mak22223/MPS_Course_Work/Технические документы/ГОСТы/19.105 ЕСПД Общие требования к программным документам.pdf

обязательная (http://www.stroyinf.ru/fire.html) | пожарная (http://www.stroyinf.ru/fire.html) | сертификация (http://www.stroyinf.ru/fire.html)
