mak22223/MPS_Course_Work/Документация/Прочее/Program Functional.png

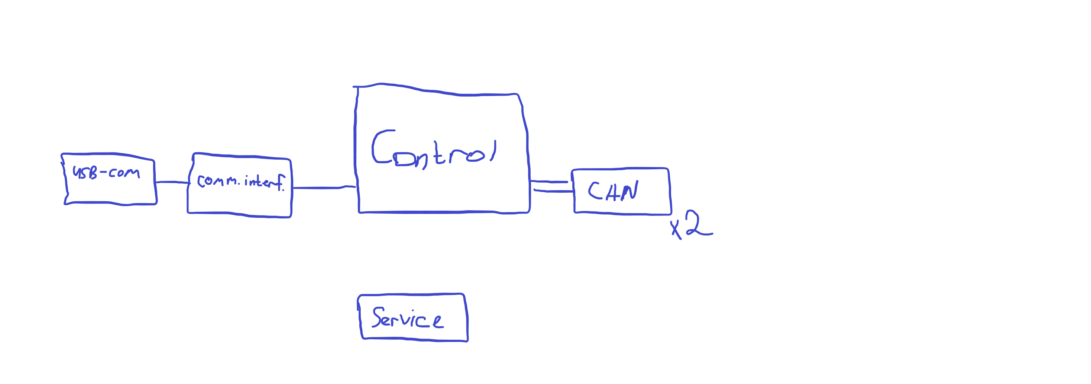
Документация/Прочее/Program Functional.png
