mak22223/MPS_Course_Work/Технические документы/Примеры схем/CAN модуль.png

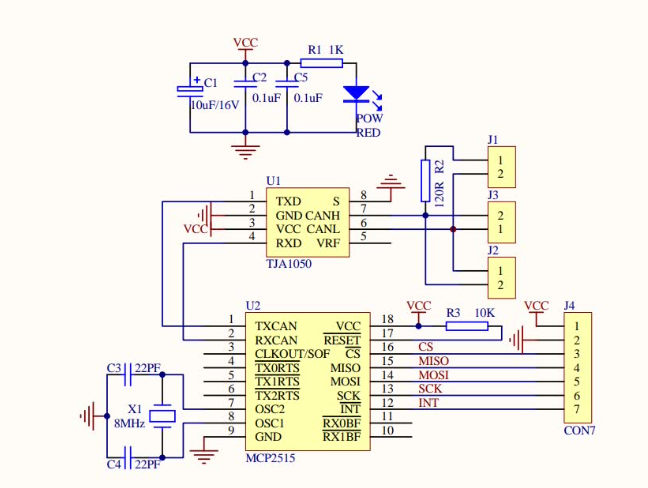
Технические документы/Примеры схем/CAN модуль.png
