mak22223/MPS_Course_Work/Сбор компонентов.xlsx

Description | Comment | Part Number | Quantity | Стоимость | Аналог? | Ссылка
25V 100nF X7R ±10% 0603 Multilayer Ceramic Capacitors MLCC | 100 nF | CL10B104KA8NNNC | 9 | 56,98
25V 10uF X5R ±20% 0603 Multilayer Ceramic Capacitors | 10 uF | CL10A106MA8NRNC | 2 | 200 |  | https://www.chipdip.ru/product0/8016016324
25V 22uF X5R ±20% 0805 Multilayer Ceramic Capacitors | 22 uF | CL21A226MAYNNNE | 2 | 175.00 ₽ |  | https://www.chipdip.ru/product0/8008936943
25V 1uF X5R ±10% 0603 Multilayer Ceramic Capacitors MLCC | 1 uF | CC0603KRX5R8BB105 | 4 | 68,03
 | 12pf | CC0603JRNPO9BN120 | 2 | 56.98 ₽
50V 10pF NP0 ±5% 0603 Multilayer Ceramic Capacitors MLCC | 10 pF | CC0603JRNPO9BN100 | 2 | 56.98 ₽
20V 450mV@1A 1A SOD-323 Schottky Barrier Diodes | Diode Shottky SOD-323 | B5817WS | 1 | 18.00 ₽ | BAT60JFILM | https://www.chipdip.ru/product/bat60jfilm
5mA Yellow -40℃~+85℃ White light 120° 100mW 0603 Light Emitting Diodes (LED) ROHS | LED White | SZYY0603W | 1 | 75.73 ₽ |  | https://aliexpress.ru/item/4000160742329.html
20mA 518nm Colorless transparence -40℃~+85℃ 520nm~535nm Emerald 120° 110mW 0603 | LED Green 0603 | 19-217/GHC-YR1S2/3T | 1
25mA Green -30℃~+85℃ Positive post Blue 120° 80mW 0603 | LED Blue 0603 | XL-1608BGWC-06 | 1
5A 1 16 Female Type-C SMD USB Connectors ROHS | TYPE-C-31-M-12 | TYPE-C-31-M-12 | 1 | 98.08 ₽
2.2A 3.3uH ±20% 2.8A 102mΩ SMD-2P,4x4mm Inductors | 3.3 mH | FDSD0412-H-3R3M=P3 | 1 | 30.00 ₽ |  | https://www.chipdip.ru/product0/8001584325
Resistor 5.1k 0603 1% | 5.1k | RC0603FR-075K1L | 2 | 33.00 ₽ |  | https://aliexpress.ru/item/1005001658504802.html
Resistor 10k 0603 1% | 10k | RC0603FR-0710KL | 5 | 33.59 ₽ |  | https://aliexpress.ru/item/1005001793547200.html
100mW Thick Film Resistors 75V ±100ppm/℃ ±1% -55℃~+155℃ 54.9kΩ 0603 | 54.9k | RC0603FR-0754K9L | 1 | 73.83 ₽ |  | https://aliexpress.ru/item/1005001658788791.html
100mW Thick Film Resistors 75V ±100ppm/℃ ±1% -55℃~+155℃ 698Ω 0603 Chip Resistor | 698 | AC0603FR-07698RL | 3 | 90.13 ₽ |  | https://aliexpress.ru/item/1005002761398457.html
Resistor 2.49k 0603 1% | 2.49k | RC0603FR-072K49L | 1 | 33.59 ₽ | 2,4k
100mW Thin Film Resistor 75V ±25ppm/℃ ±1% -55℃~+155℃ 33kΩ 0603 Chip Resistor | 33k | ARG03FTC3302 | 1 | 33.59 ₽
100mW Thick Film Resistors 50V ±100ppm/℃ ±1% -55℃~+155℃ 82kΩ 0603 Chip Resistor | 82k | FRC0603F8202TS | 1 | 33.59 ₽
Thick Film Resistors -55℃~+155℃ 0Ω 0603 Chip Resistor | 0 | FRC0603P000 TS | 2 | 33.59 ₽
 | SPST Switch | B3U-1000P | 1 | 28.84 ₽ | 3X4X2.5MM | https://aliexpress.ru/item/1005004067514307.html
TJA1050 CAN Transeiver up to 1 Mbaud/s | TJA1050 | TJA1057T/1Z | 2 | 284.15 ₽ | TJA1042 | https://aliexpress.ru/item/32859530246.html
 | USBLC6-2 | USBLC6-2SC6 | 1 | 69.96 ₽ |  | https://aliexpress.ru/item/32523780535.html
Step-down type -40℃~+125℃@(TJ) 1 Step-down Adjustable 0.768V~7V 3A 4.5V~17V 580kHz SOT-23-THIN-6 | TPS563201 | TPS563201DDCR | 1 | 94.47 ₽ |  | https://aliexpress.ru/item/32960176118.html
40dB@(1kHz) 100mA 240mV@(50mA) Fixed 3.3V~3.3V Positive 1 8V SOT-23 Linear Voltage Regulators | XC6206P332MR | XC6206P332MR | 1 | 69.23 ₽ |  | https://aliexpress.ru/item/32843668794.html
ARM Cortex-M3 32-bit MCU, 128 KB Flash, 64 KB Internal RAM, 51 I/Os, 64-pin LQFP, -40 to 85 degC, Tray | STM32F105RBT6 | STM32F105RBT6 | 1 | 342.58 ₽ | ??? | https://aliexpress.ru/item/1005003822567413.html
32.768kHz 6pF 70kΩ ±20ppm -40℃~+85℃ SMD3215-2P Crystals ROHS | 32.768MHz | NX3215SA-32.768K-STD-MUA-14 | 1 | 88.00 ₽ |  | https://www.chipdip.ru/product0/9000523964
Crystal 8MHz 10pf 250Ohm | 8MHz | TAXM8M4RDBCCT2T | 1 | 45.00 ₽ | ??? | https://www.chipdip.ru/product0/8010530408 | Можно? | https://www.chipdip.ru/product0/9000523954 | https://www.chipdip.ru/product0/8010531849
 |  |  |  | 2097.91
