mak22223/MPS_Course_Work/ТЗ.xlsx

Sheet: Функциональные требования
Техническое задание для адаптера J2534
Поддерживаемые функции: |  | Общие характеристики: |  |  | Задачи устройства:
1 |  | 1 | Работа в бортовых сетях +12В |  | 1 | Подключение к ТС посредством разъема J1962
2 |  | 2 | Поддержка CAN (J1962) |  | 2 | Наличие внешних выводов для подключения шин CAN
 |  | 3 | Поддержка MS-CAN
 |  | 4 | Наличие внешних выводов для подключения шин CAN |  | 3 | Связь с ЭВМ посредством USB
 |  |  |  |  | 4 | Питание устройства как от БС автомобиля, так и от USB +5V
 |  | 5 | Питание от USB
 |  | 6 | Передача данных по USB |  | 5 | Соответствие информационного интерфейса стандарту J2534
 |  |  |  |  | 6 | В рамках одного сеанса J2534 одновременно: а) Читать из двух различных шин CAN б) Записывать в две различные шины CAN
Список сокращений |  |  | Микросхемы
БС | бортовая сеть |  | LM317M
ТС | транспортное средство |  | L9637
 |  |  | XL1509 | DC-DC Step Down

Sheet: Использованные источники
Использованные документы
Номер | Название | Ссылка | Дата обращения
1 | Linear and Switching Voltage Regulator Fundamentals | https://www.ti.com/lit/an/snva558/snva558.pdf | 2022-09-25
2 | LDO Basics | https://www.ti.com/lit/eb/slyy151a/slyy151a.pdf | 2022-09-25
3 | USB Orientation & Mount Types | https://gct.co/usb-connector/usb-orientations-and-mount-types | 2022-10-15
4 | USB Type-C | https://ru.wikipedia.org/wiki/USB_Type-C | 2022-10-15
5 | USBLC6-2 Datasheet | https://www.st.com/resource/en/datasheet/usblc6-2.pdf | 2022-10-16 | https://static.chipdip.ru/lib/472/DOC014472505.pdf
6 | USB Type C: распиновка, режимы и особенности применения | http://digitrode.ru/articles/1697-usb-type-c-raspinovka-rezhimy-i-osobennosti-primeneniya.html | 2022-10-17
7 | Как начать использовать USB Type-C в своих разработках | https://habr.com/ru/company/ntc-vulkan/blog/496882/ | 2022-10-17
8 | Oscillator design guide | https://www.st.com/resource/en/application_note/an2867-oscillator-design-guide-for-stm8afals-stm32-mcus-and-mpus-stmicroelectronics.pdf | 2022-10-23
9 | Интерфейс JTAG? — Это очень просто | https://habr.com/ru/post/190012/ | 2022-10-24
10 | STM32 microcontroller debug toolbox | https://www.st.com/resource/en/application_note/an4989-stm32-microcontroller-debug-toolbox-stmicroelectronics.pdf | 2022-10-24
11 | Switching regulator fundamentals | https://www.ti.com/lit/an/snva559c/snva559c.pdf?ts=1668033055473 | 2022-11-10
12 | TPS56320x Datasheet | https://www.ti.com/lit/ds/symlink/tps563201.pdf?ts=1668072977388 | 2022-11-10
13 | PCB Layout Guidelines for Power Controllers | https://www.ti.com/lit/ml/slua366/slua366.pdf | 2022-11-10
14 | Altium Academy Youtube Channel | https://www.youtube.com/@AltiumAcademy | 2022-11-14
15 | EEVblog Youtube Channel | https://www.youtube.com/@EEVblog | 2022-11-13
16 | Altium Education | https://education.altium.com/ | 2022-09-24
17 | Introduction to USB with STM32 | https://wiki.stmicroelectronics.cn/stm32mcu/wiki/Introduction_to_USB_with_STM32 | 2022-12-19
18
19
20
21
22
23
24
25
26
27
28
29
30
31
32
33
34

Sheet: VCP Protocol
1 | Команда | PassThruConnect | Все числа в шестнадцатиричной системе
 | Входной синтаксис | connect 5,c001 (ProtocolID, Flags)
 | Выходной синтаксис | 1 (ChannelID) / NOT_SUPPORTED (Error Code)
2 | Команда | PassThruDisconnect
 | Входной синтаксис | disconnect 1 (ChannelID)
 | Выходной синтаксис | OK (Error Code)
3 | Команда | PassThruReadMsgs
 | Входной синтаксис | readmsgs 1,2,10 (ChannelID, NumMsgs, Timeout)
 | Выходной синтаксис | Сообщения протокола, разделенные '\r' / ERROR (Error Code)
4 | Команда | PassThruWriteMsgs
 | Входной синтаксис | writemsgs 1,01A4C3D29D93F2A000C (ChannelID, Msg)
 | Выходной синтаксис | OK (Error Code)
 | Ограничения | Нет возможности отправить несколько сообщений за раз
5 | Команда | PassThruStartPeriodicMsg
 | Входной синтаксис | startperiodicmsgs 1,01A4C3D29D93F2A000C,100 (ChannelID, Msg, TimeInterval)
 | Выходной синтаксис | 3 (MsgID) / ERROR (Error Code)
6 | Команда | PassThruStopPeriodicMsg
 | Входной синтаксис | stopperiodicmsgs 1,3 (ChannelID, MsgID)
 | Выходной синтаксис | OK (Error Code)
7 | Команда | PassThruStartMsgFilter
 | Входной синтаксис | startmsgfilter 1,0,21df432ab432,2123afc321,21ad3424 (ChannelID, FilterType, MaskMsg, PatternMsg, FlowControlMsg)
 | Выходной синтаксис | 5 (MsgID) / ERROR (Error Code)
8 | Команда | PassThruStopMsgFilter
 | Входной синтаксис | stopmsgfilter 1,5 (ChannelID, MsgID)
 | Выходной синтаксис | OK (Error Code)
9 | Команда | PassThruSetProgrammingVoltage
 | Входной синтаксис | setprogvoltage 6,20000 (PinNumber, Voltage)
 | Выходной синтаксис | OK (Error Code)
10 | Команда | PassThruReadVersion
 | Входной синтаксис | readversion
 | Выходной синтаксис | Firmware version string / ERROR (Error Code)
11 | Команда | PassThruGetLastError
 | Входной синтаксис | getlasterror
 | Выходной синтаксис | Error String / ERROR (Error Code)
12 | Команда | PassThruIoctl
 | Входной синтаксис | ioctl 1,7,9032ad214f (ChannelID, IoctlID, Input)
 | Выходной синтаксис | Output structure / ERROR (Error Code)
12.1 | Команда | PassThruIoctl (GET_CONFIG)
 | Входной синтаксис | ioctl 1,1,5,2,3,5,6,9 (количество и список запрашиваемых параметров)
 | Выходной синтаксис | Список параметров, разделенные '\r' / ERROR (Error Code)
12.2 | Команда | PassThruIoctl (SET_CONFIG)
 | Входной синтаксис | ioctl 1,2,5,2,500,3,200,5,600,6,1,9,0 (количество пар, параметров и значений)
 | Выходной синтаксис | OK (Error Code) (или список кодов ошибок)

Sheet: Функциональные блоки
Debug connector |  | SAE J1962 connector |  | Main module
1 | Подключение отладочных интерфейсов JTAG/SWD к МК | 1 | Подключение питания +12В и земли | 1 | Управление PPS
 |  | 2 | Подключение HS CAN и MS CAN | 2 | Отправка и чтение из шины CAN
2 | Подача питания на МК | 3 | Подключение программируемого источника питания | 3 | Выбор шины CAN
 |  |  |  | 4 | Измерение напряжения бортовой сети
 |  |  |  | 5 | Работа с USB
Power supply |  | USB connector |  | 6 | Работа с JTAG/SWD
1 | Одновременное питание от +12В и +5В | 1 | Подключение питания +5В
2 | Питание МК и периферии | 2 | Подключение линий данных USB к МК
3 | Замер напряжения бортовой сети
CAN transceiver |  | Programmable power supply
1 | Переключение между HS/MS CAN | 1 | Выбор выходного напряжения 5-20В
 |  | 2 | Осуществление подачи напряжения на выходы 6, 9, 11, 12, 13, 14
 |  | 3 | Замыкание на землю контакта 15

Sheet: Компоненты
Список компонентов
Номер | Part Number | Название | Кол-во | Ссылка
1 | 105450-0101 | Type-C Receptable Top-Mount | 1 | (тык) (https://www.molex.com/molex/products/part-detail/io_connectors/1054500101) | PLS | https://static.chipdip.ru/lib/977/DOC005977245.pdf
2 | GD32F105RBT6 | Microcontroller | 1 | (тык) (https://www.gigadevice.com/microcontroller/gd32f105rbt6/)
3 | TAXM8M4RDBCCT2T | Crystal Oscillator |  | (тык)
4 |  |  |  | (тык)
5 |  |  |  | (тык)
6 |  |  |  | (тык)
7 |  |  |  | (тык)
8 |  |  |  | (тык)
9 |  |  |  | (тык)
10 |  |  |  | (тык)
11 |  |  |  | (тык)
12 |  |  |  | (тык)
13 |  |  |  | (тык)
14 |  |  |  | (тык)
15 |  |  |  | (тык)
16 |  |  |  | (тык)
17 |  |  |  | (тык)
18 |  |  |  | (тык)
19 |  |  |  | (тык)
20 |  |  |  | (тык)
21 |  |  |  | (тык)
22 |  |  |  | (тык)
23 |  |  |  | (тык)

Sheet: Кварц
Расчет цепей кварцевого резонатора:
Параметры резонатора |  |  |  |  | Константы | Переменные:
C_L, pF | C_0, pF | ESR, Ohm | F, MHz | Dlmax, uW | g_m, A/V | R_EXT
10 | 7 | 250 | 8 | 10 | 0.025 | 10000
g_mcrit | 0.000730192812 | A/V | Iqmax | 0.0002
g_mcritREXT |  | A/V | Iq | 0.0132
gain_margin | #DIV/0! |  | IQREXT | 0.0003219512195 | нет

Sheet: DC-DC
DC-DC
IIp-p | 1.795977011 | 5.00 | x | 16.00 | - | 5.00
 |  | 16.00 |  | 3.3e-06 | x | 580000
Iipeak | 1.397988506 | 0.5 | + | 1.795977011
 |  |  |  | 2
ILO(RMS) | 0.720273873 | 0.25 | + | 1 | 3.225533426
 |  |  |  | 12

Sheet: CAN Timing
 | Скорость тактирования | 8 | МГц | Tq | 1.6e-08
 |  |  |  | Подбираемые |  |  |  | Результирующие |  | Вычисления
 | Константы | Скорость, кГц | Sample Point | BRP | PRSEG | PHSEG1 | PHSEG2 | Скорость, кГц | Sample Point | Tq | Desirable Bit Time | Bit Time | Tdelay | SyncSeg | Func | PS+PS1 | PS2 | BRP MAX | PRSEG MAX | PHSEG1 MAX | PHSEG2 MAX | PHSEG2 MIN
SJW | 0 | 250 | 0.685 | 0 | 4 | 4 | 4 | 250 | 0.6875 | 2.5e-07 | 4e-06 | 4e-06 | 2 | 1 | 6.25e-06 | 10 | 5 | 63 | 7 | 7 | 7 | 2 | #NAME? | 4 | #VALUE! | TRUE | TRUE | TRUE | TRUE | TRUE | TRUE | TRUE | TRUE | 32767 | 0
SAM | 0 | 250 | 0.8 | 0 | 6 | 4 | 2 | 250 | 0.8125 | 2.5e-07 | 4e-06 | 4e-06 | 2 | 1 | 0.00015625 | 12 | 3 | 63 | 7 | 7 | 7 | 2 | #NAME? | 4 | #VALUE! | TRUE | TRUE | TRUE | TRUE | TRUE | TRUE | TRUE | TRUE | 32767 | 0
BTLMODE | 1 | 500 | 0.685 | 0 | 1 | 1 | 2 | 500 | 0.625 | 2.5e-07 | 2e-06 | 2e-06 | 2 | 1 | 0.0036 | 4 | 3 | 63 | 7 | 7 | 7 | 2 | #NAME? | 4 | #VALUE! | TRUE | TRUE | TRUE | TRUE | TRUE | TRUE | TRUE | TRUE | 32767 | 0
SOF | 0 | 500 | 0.8 | 0 | 0 | 2 | 2 | 500 | 0.625 | 2.5e-07 | 2e-06 | 2e-06 | 2 | 1 | 0.030625 | 4 | 3 | 63 | 7 | 7 | 7 | 2 | #NAME? | 4 | #VALUE! | TRUE | TRUE | TRUE | TRUE | TRUE | TRUE | TRUE | TRUE | 32767 | 0
WAKFIL | 0 | 125 | 0.685 | 1 | 1 | 6 | 5 | 125 | 0.625 | 5e-07 | 8e-06 | 8e-06 | 2 | 1 | 0.0036 | 9 | 6 | 63 | 7 | 7 | 7 | 2 | #NAME? | 4 | #VALUE! | TRUE | TRUE | TRUE | TRUE | TRUE | TRUE | TRUE | TRUE | 32767 | 0
 |  | 125 | 0.8 | 1 | 4 | 6 | 2 | 125 | 0.8125 | 5e-07 | 8e-06 | 8e-06 | 2 | 1 | 0.00015625 | 12 | 3 | 63 | 7 | 7 | 7 | 2 | #NAME? | 4 | #VALUE! | TRUE | TRUE | TRUE | TRUE | TRUE | TRUE | TRUE | TRUE | 32767 | 0

Sheet: Функциональные объекты
USB-COM: | Входные сигналы | Выходные сигналы
Установка скорости соединения
Взаимодействие с ПК
Communication Interface:
Обработка сигналов от COM
Вызов необходимых обработчиков от Control
Обратная связь к ПК
CAN_MCP2515:
Инициализация MCP2515
Обработка прерываний (чтение/отправка сообщений)
Настройка параметров CAN
Установка фильтров
Control:
Управление интерфейсами
Обработка команд от интерфейса взаимодействия
Service:
Первичная настройка МК и периферии

Sheet: Недочеты
 | Плата
1 | Расчет тока светодиодов проведен неверно (номиналов резисторов)
2 | Светодиоды возможно имеет смысл подключать к 5V линии.
3 | Светодиодами стоит управлять в режиме открытого коллектора
4 | Проверить выбранную катушку на ток
 | Код
1 | Возвращаемое значение метода isCapableOf должно зависеть не только от интерфейса
2 | Класс MCP2515 не разделяет расширенные и стандартные кадры и не может работать с ISO15765
