mak22223/MPS_Course_Work/Документация/PDF/МаркинМА_ИУ6-74Б_Перечень_элементов.pdf

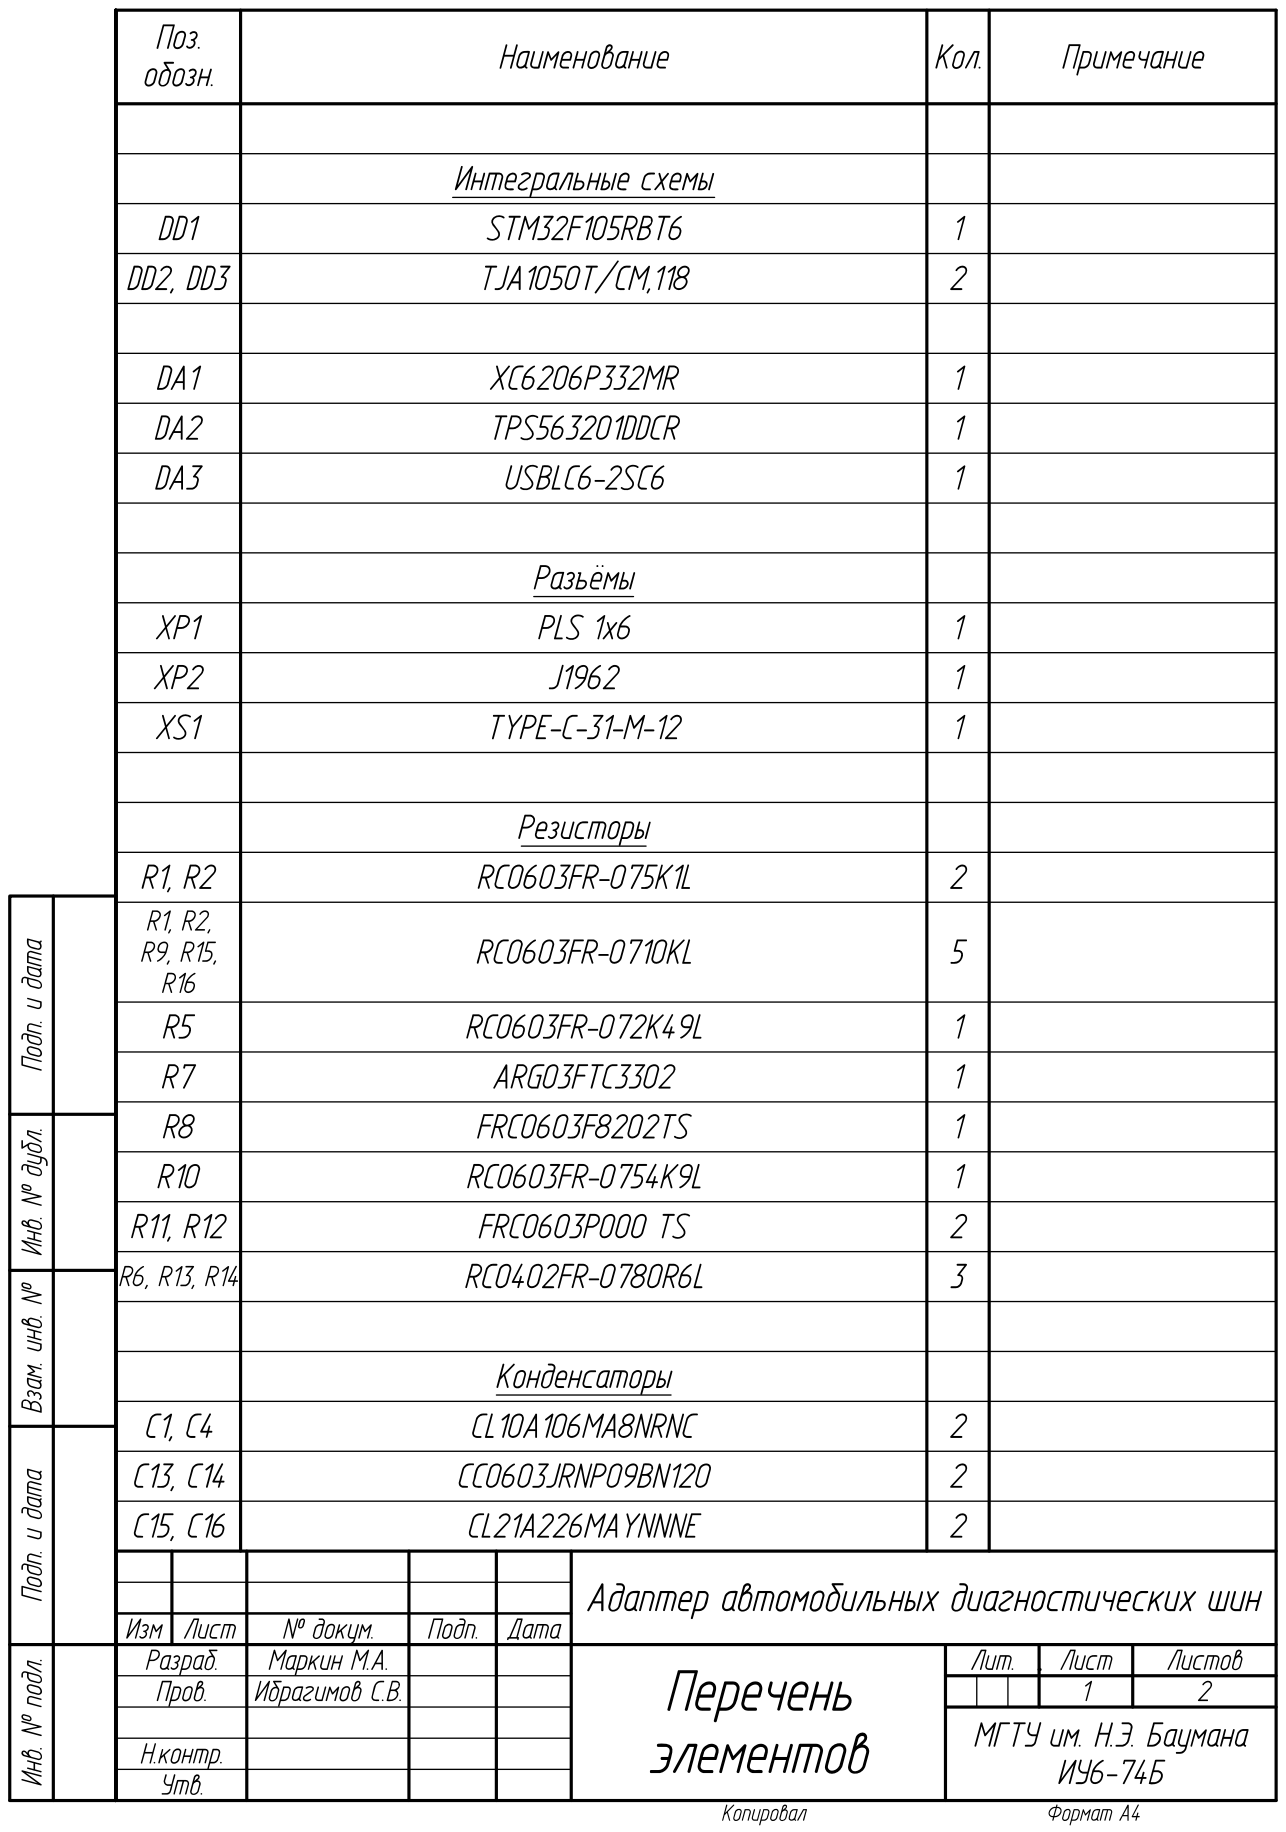
[picture p40: page 1]

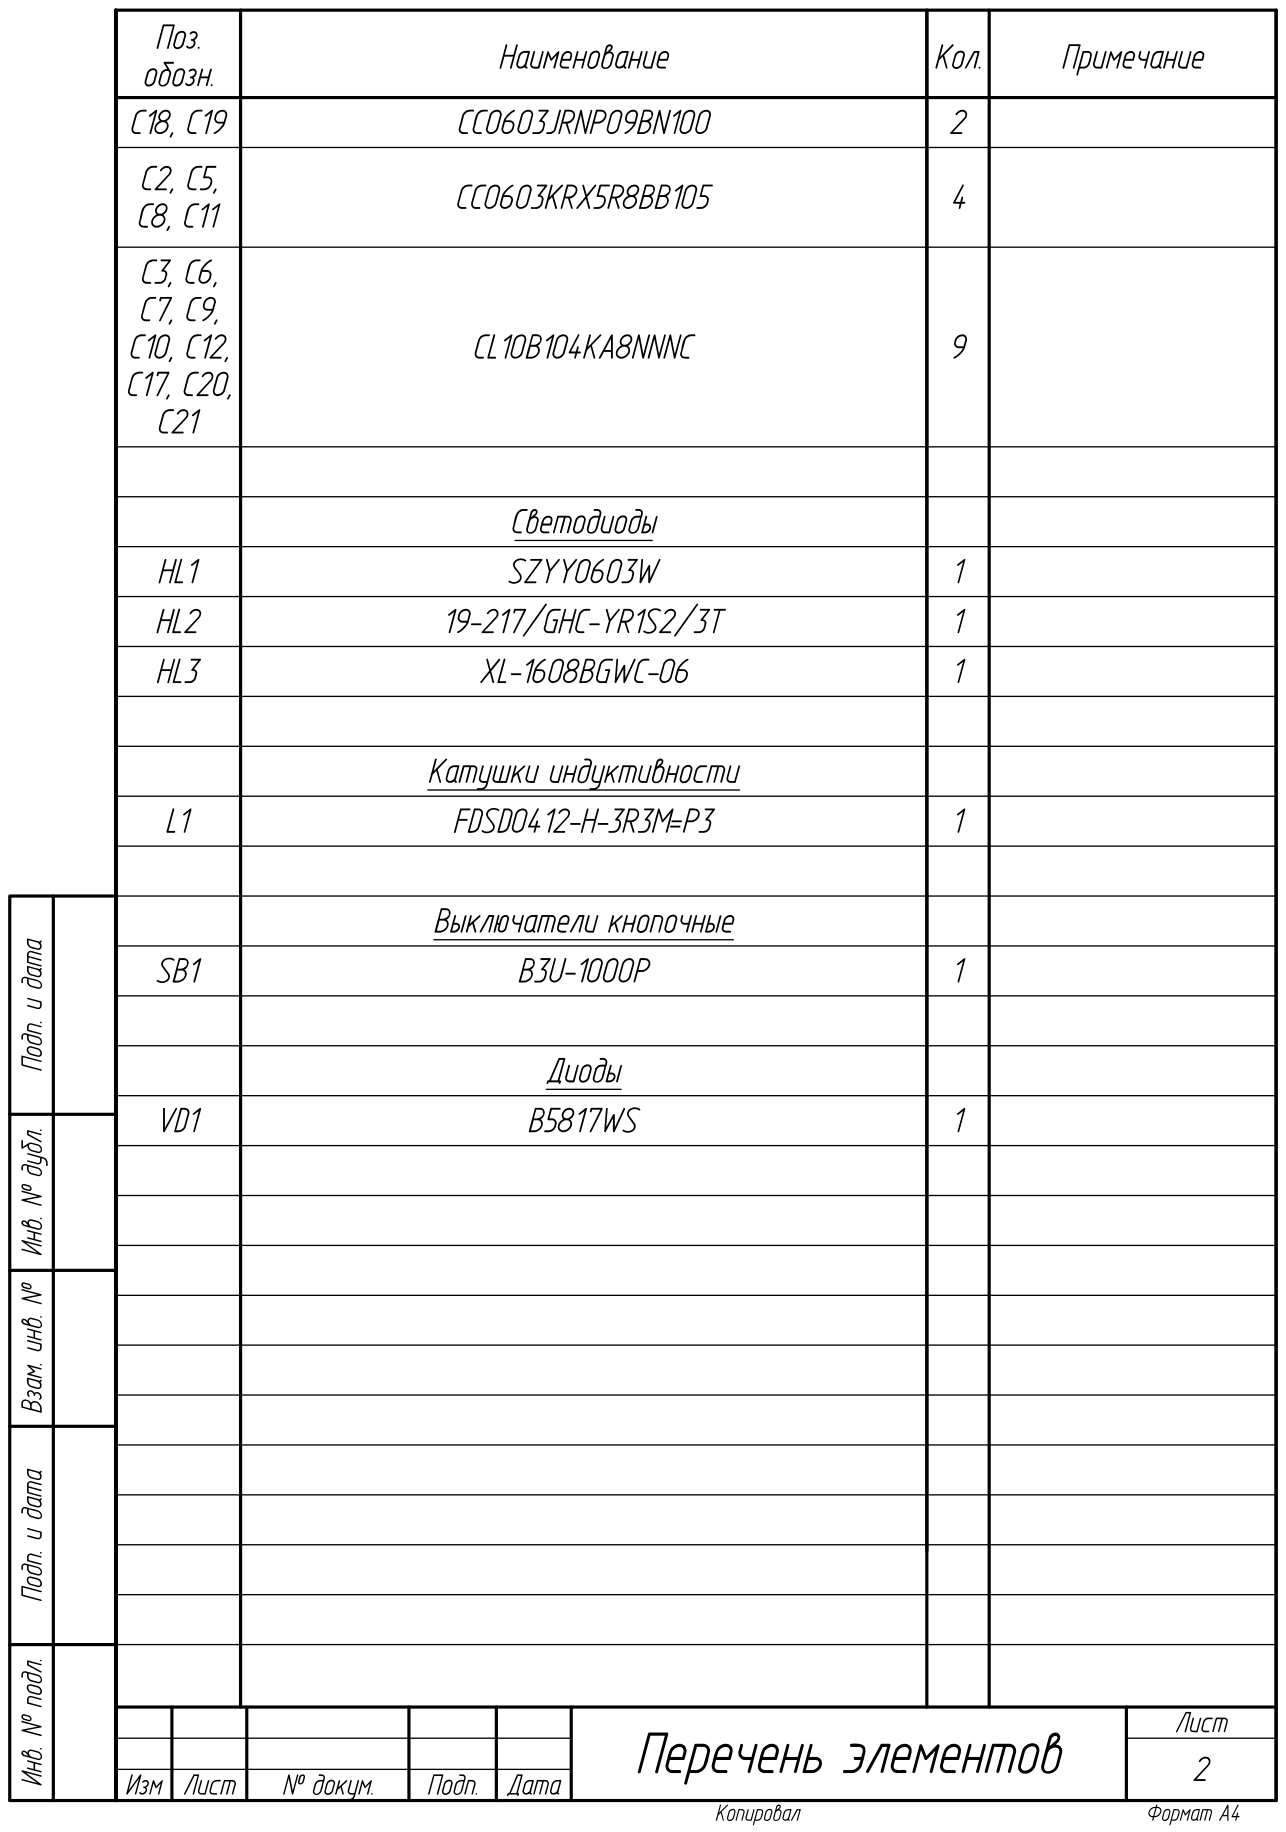
[picture p41: page 2]
