mak22223/MPS_Course_Work/Документация/PDF/МаркинМА_ИУ6-74Б_Принципиальная.pdf

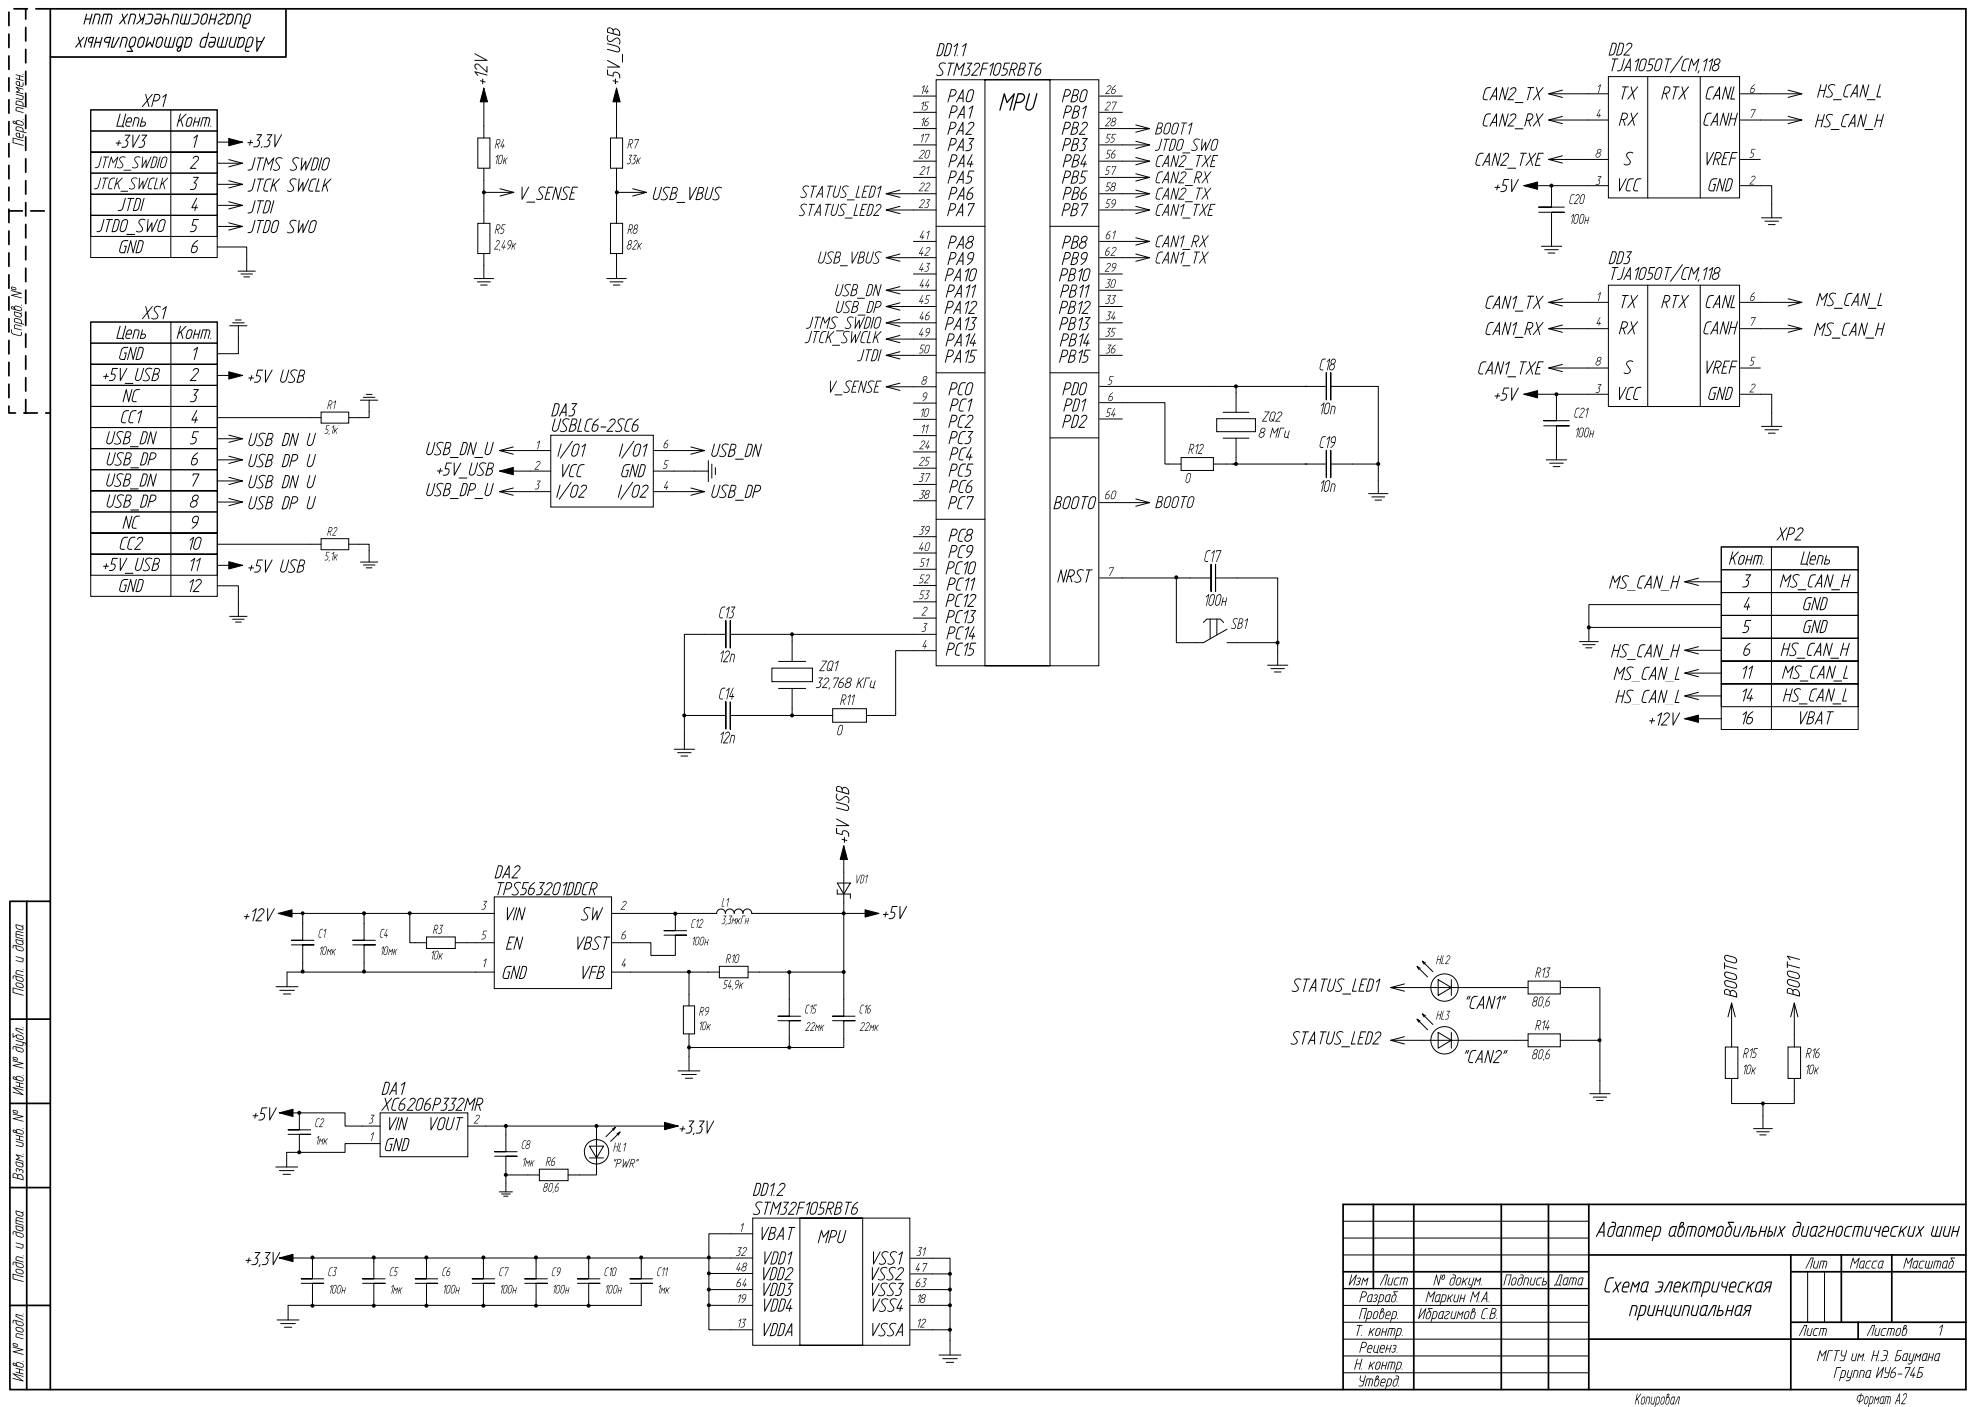
[picture p42: page 1]
