mak22223/MPS_Course_Work/Документация/PDF/МаркинМА_ИУ6-74Б_Функциональная.pdf

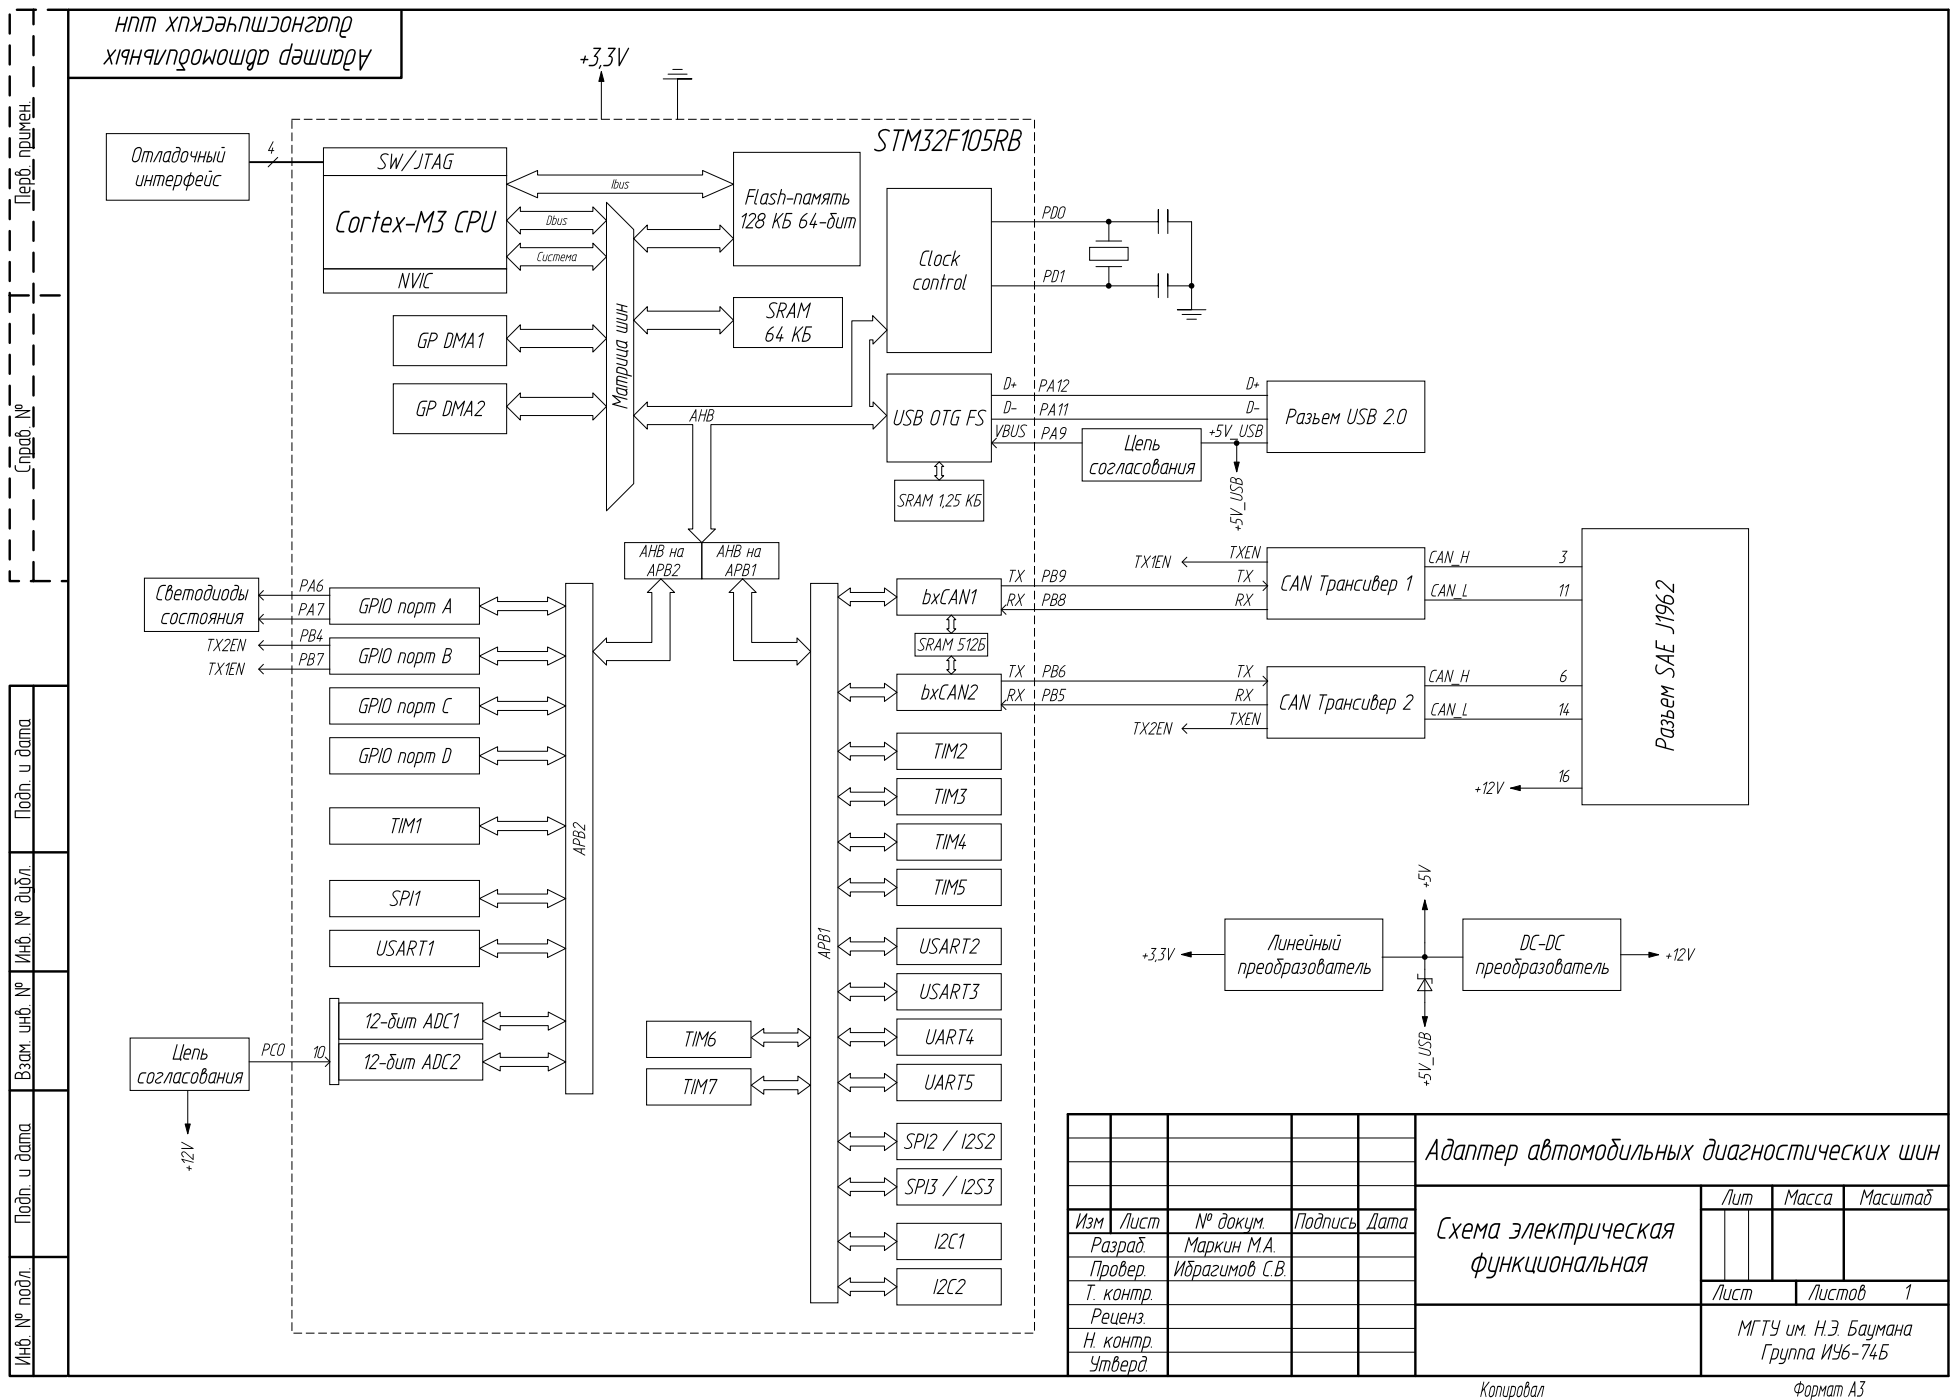
[picture p43: page 1]
