mak22223/MPS_Course_Work/Схема/J2534 Adapter/Main_Board.pdf

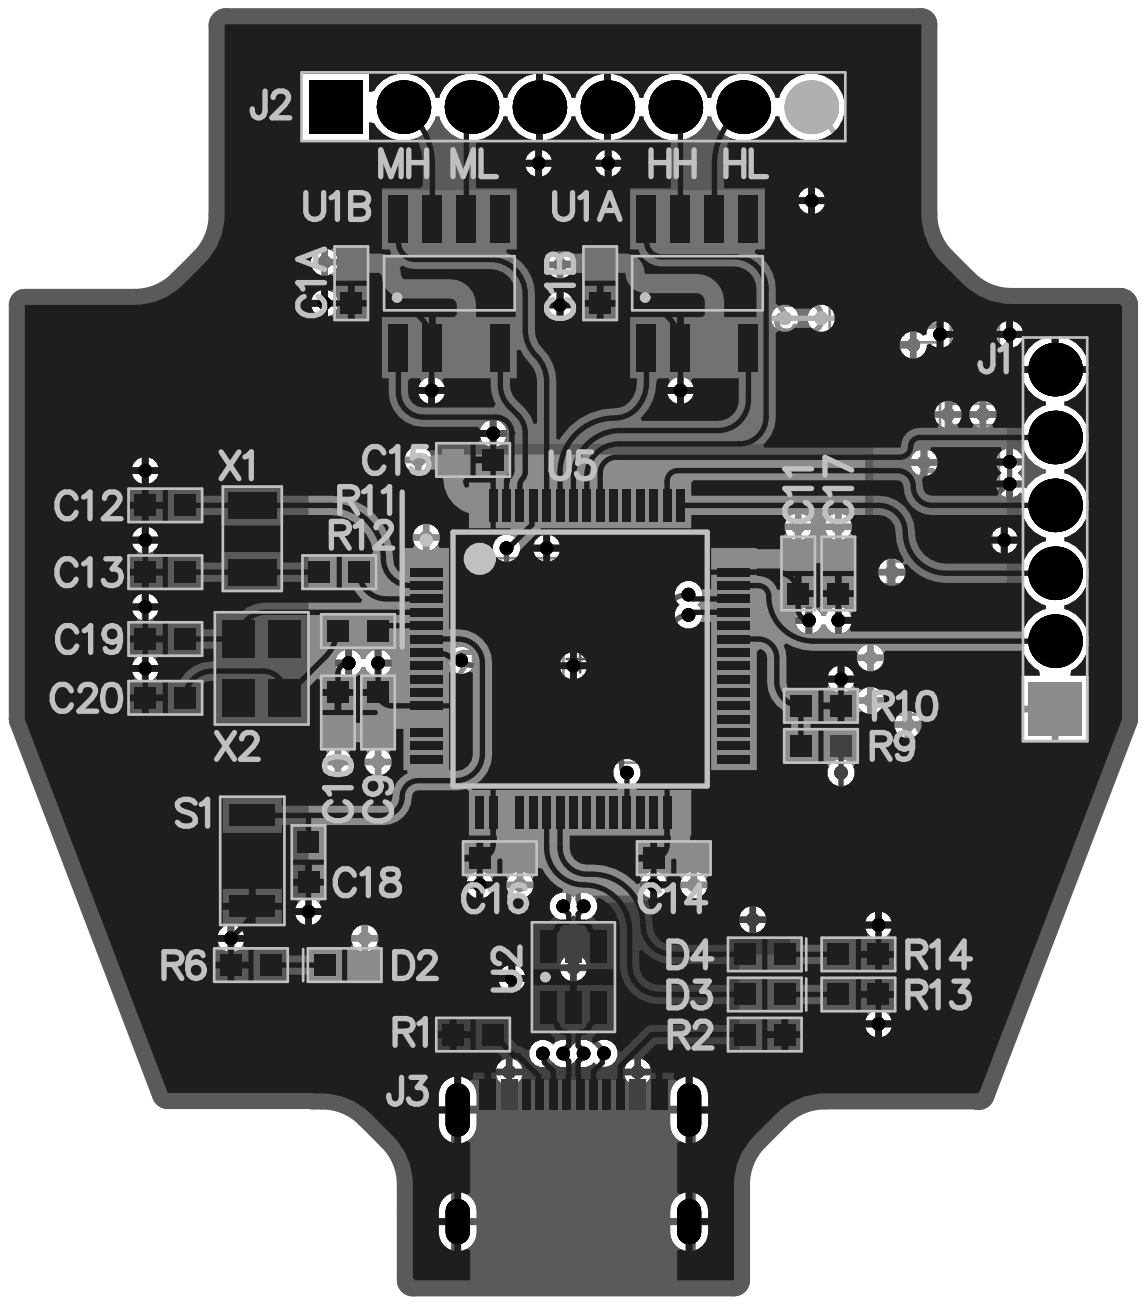
[picture p44: page 1]
