mak22223/MPS_Course_Work/(list of files, drawings)

Other design files:
Документация/Диаграммы/Backup_of_layout.spl8
Документация/Диаграммы/Backup_of_Принципиальная_ориг.spl8
Документация/Диаграммы/Backup_of_Принципиальная_ориг_А2.spl8
Документация/Диаграммы/Backup_of_Структурная.spl8
Документация/Диаграммы/Backup_of_Функциональная_ориг.spl8
Документация/Диаграммы/layout.spl8
Документация/Диаграммы/Перечень элементов_ориг.spl8
Документация/Диаграммы/Принципиальная_ориг.spl8
Документация/Диаграммы/Принципиальная_ориг_А2.spl8
Документация/Диаграммы/Структурная.spl8
Документация/Диаграммы/Функциональная.spl8
Документация/Диаграммы/Функциональная_ориг.spl8
Схема/J2534 Adapter/Adapter_Func.SchDoc
Схема/J2534 Adapter/CAN Interface.SchDoc
Схема/J2534 Adapter/J1962 Connector.SchDoc
Схема/J2534 Adapter/J2534 Adapter.PrjPcb
Схема/J2534 Adapter/JTAG-SW Connector.SchDoc
Схема/J2534 Adapter/Main_Board.PcbDoc
Схема/J2534 Adapter/Max_lib.PcbLib
Схема/J2534 Adapter/Max_lib.SchLib
Схема/J2534 Adapter/Microcontroller.SchDoc
Схема/J2534 Adapter/Power Supply.SchDoc
Схема/J2534 Adapter/Primitives Main_Board.PcbDoc
Схема/J2534 Adapter/USB Connector.SchDoc
