mak22223/MPS_Course_Work/(commit log)

2022-11-11 Altium files import
    [Adapter_Func.SchDoc, CAN Interface.SchDoc, J1962 Connector.SchDoc, J2534 Adapter.PrjPcb, JTAG-SW Connector.SchDoc, Main_Board.PcbDoc, Max_lib.PcbLib, Max_lib.SchLib]
2022-11-11 Finished functional schematic
    [Adapter_Func.SchDoc, J2534 Adapter.PrjPcb, Main_Board.PcbDoc, Max_lib.PcbLib, Max_lib.SchLib, Microcontroller.SchDoc, Power Supply.SchDoc]
2022-11-12 Prepared for board routing
    [Adapter_Func.SchDoc, CAN Interface.SchDoc, J1962 Connector.SchDoc, J2534 Adapter.PrjPcb, JTAG-SW Connector.SchDoc, Main_Board.PcbDoc, Max_lib.PcbLib, Max_lib.SchLib]
2022-11-14 Some schematic changes, smaller packages for resistors and capacitors Partial board layout
    [J2534 Adapter.PrjPcb, Main_Board.PcbDoc, Max_lib.PcbLib, Max_lib.SchLib, Microcontroller.SchDoc, USB Connector.SchDoc]
2022-11-16 Board pre-layout finished
    [CAN Interface.SchDoc, Main_Board.PcbDoc, Max_lib.SchLib, Microcontroller.SchDoc, Power Supply.SchDoc]
2022-11-17 Board routing finished Type-C receptable changed Some misc component footprint changes
    [Adapter_Func.SchDoc, J1962 Connector.SchDoc, J2534 Adapter.PrjPcb, JTAG-SW Connector.SchDoc, Main_Board.PcbDoc, Max_lib.PcbLib, Max_lib.SchLib, Microcontroller.SchDoc]
2022-11-17 Altium files upload
    [ТЗ.xlsx]
2022-11-18 Preparations before production
    [J2534 Adapter.PrjPcb, Main_Board.PcbDoc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]
2022-11-24 Production files
    [J1962 Connector.SchDoc, J2534 Adapter.PrjPcb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]
2022-12-26 26.12.2022 files update
    [Backup_of_Принципиальная_ориг.spl8, Backup_of_Структурная.spl8, Backup_of_Функциональная_ориг.spl8, J2534 Adapter.PrjPcb, Main_Board.PcbDoc, Max_lib.SchLib, Microcontroller.SchDoc, Power Supply.SchDoc]
2022-12-26 Предвариательная версия
    [Backup_of_Принципиальная_ориг.spl8, Backup_of_Функциональная_ориг.spl8, Принципиальная_ориг.spl8, Принципиальная_ориг_А2.spl8, ТЗ.xlsx, Функциональная_ориг.spl8]
2022-12-27 РПЗ обновлено
    [Backup_of_Принципиальная_ориг_А2.spl8, Backup_of_Функциональная_ориг.spl8, Перечень элементов_ориг.spl8, Принципиальная_ориг_А2.spl8, ТЗ.xlsx, Функциональная_ориг.spl8]
2022-12-28 Финальная версия без кода
    [Принципиальная_ориг_А2.spl8, Функциональная_ориг.spl8]
2022-12-28 Убраны лишние pdf файлы
2023-01-08 Before January revision
    [Main_Board.PcbDoc]
2023-01-18 Rev 1.0 Final Changed board size Added silk text Shifted power supply zone down
    [J2534 Adapter.PrjPcb, Main_Board.PcbDoc]
2023-01-18 Removed excess Altium and output files
    [Pick Place for Main_Board.csv, Pick Place for Main_Board1.csv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]
2023-01-18 Updated tech documents
    [Сбор компонентов.xlsx, ТЗ.xlsx]
2023-01-18 Rev 1.1 - Changed crystals and their load capacitors - Changed DC+DC inductor - Status LED are now open-drain controlled - Changed reset button - Added BOOT0 button - Replaced TJA1050 with TJA1051T -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
    [CAN Interface.SchDoc, J2534 Adapter.PrjPcb, Main_Board.PcbDoc, Max_lib.PcbLib, Max_lib.SchLib, Microcontroller.SchDoc, Power Supply.SchDoc]
2023-01-18 Rev 1.1 - Added board shape layer primitives - Changed connector headers pads
    [Main_Board.PcbDoc, Max_lib.PcbLib]
2023-01-18 Rev 1.1 - Restored solder mask expansion for all pads
    [Main_Board.PcbDoc]
